besser435/Binary-NeoPixel-Clock/README.md

# Lightbeam S3
 
TODO:<br>
Take picutres<br>
Make CP build and upload to CP website<br>
