besser435/Binary-NeoPixel-Clock/3d_models/print_files/Lightbeam S3 Body.3mf

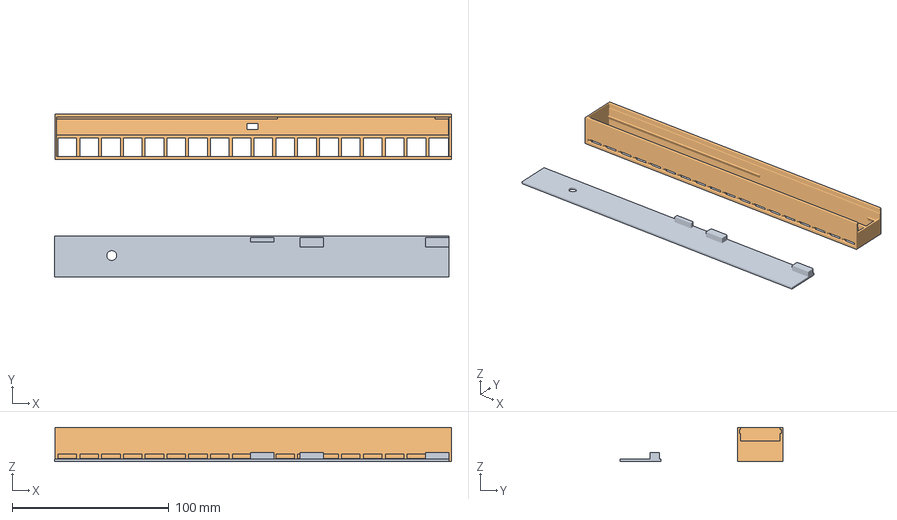
[picture p1: CAD file, 2024-04-17]
3d_models/print_files/Lightbeam S3 Body.3mf
253.3 x 104.3 x 22.0 mm
Lightbeam S3 (11).stl_1
Lightbeam S3 (11).stl_2
