besser435/Binary-NeoPixel-Clock/3d_models/print_files/Lightbeam S3 Diffuser.3mf

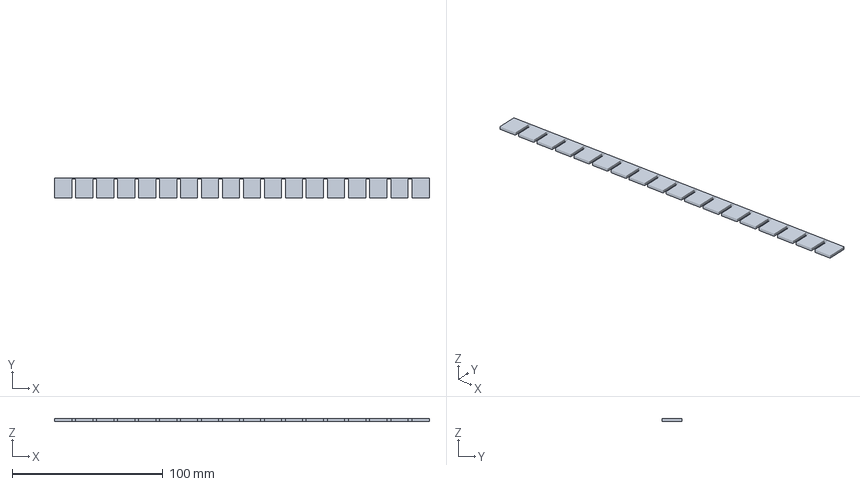
[picture p2: CAD file, 2024-04-17]
3d_models/print_files/Lightbeam S3 Diffuser.3mf
248.5 x 13.3 x 1.80 mm
