besser435/Binary-NeoPixel-Clock/lightbeam_s3_PCB/lightbeam_s3.kicad_pcb

## KiCad design lightbeam_s3_PCB/lightbeam_s3.kicad_pcb (2024-05-27)

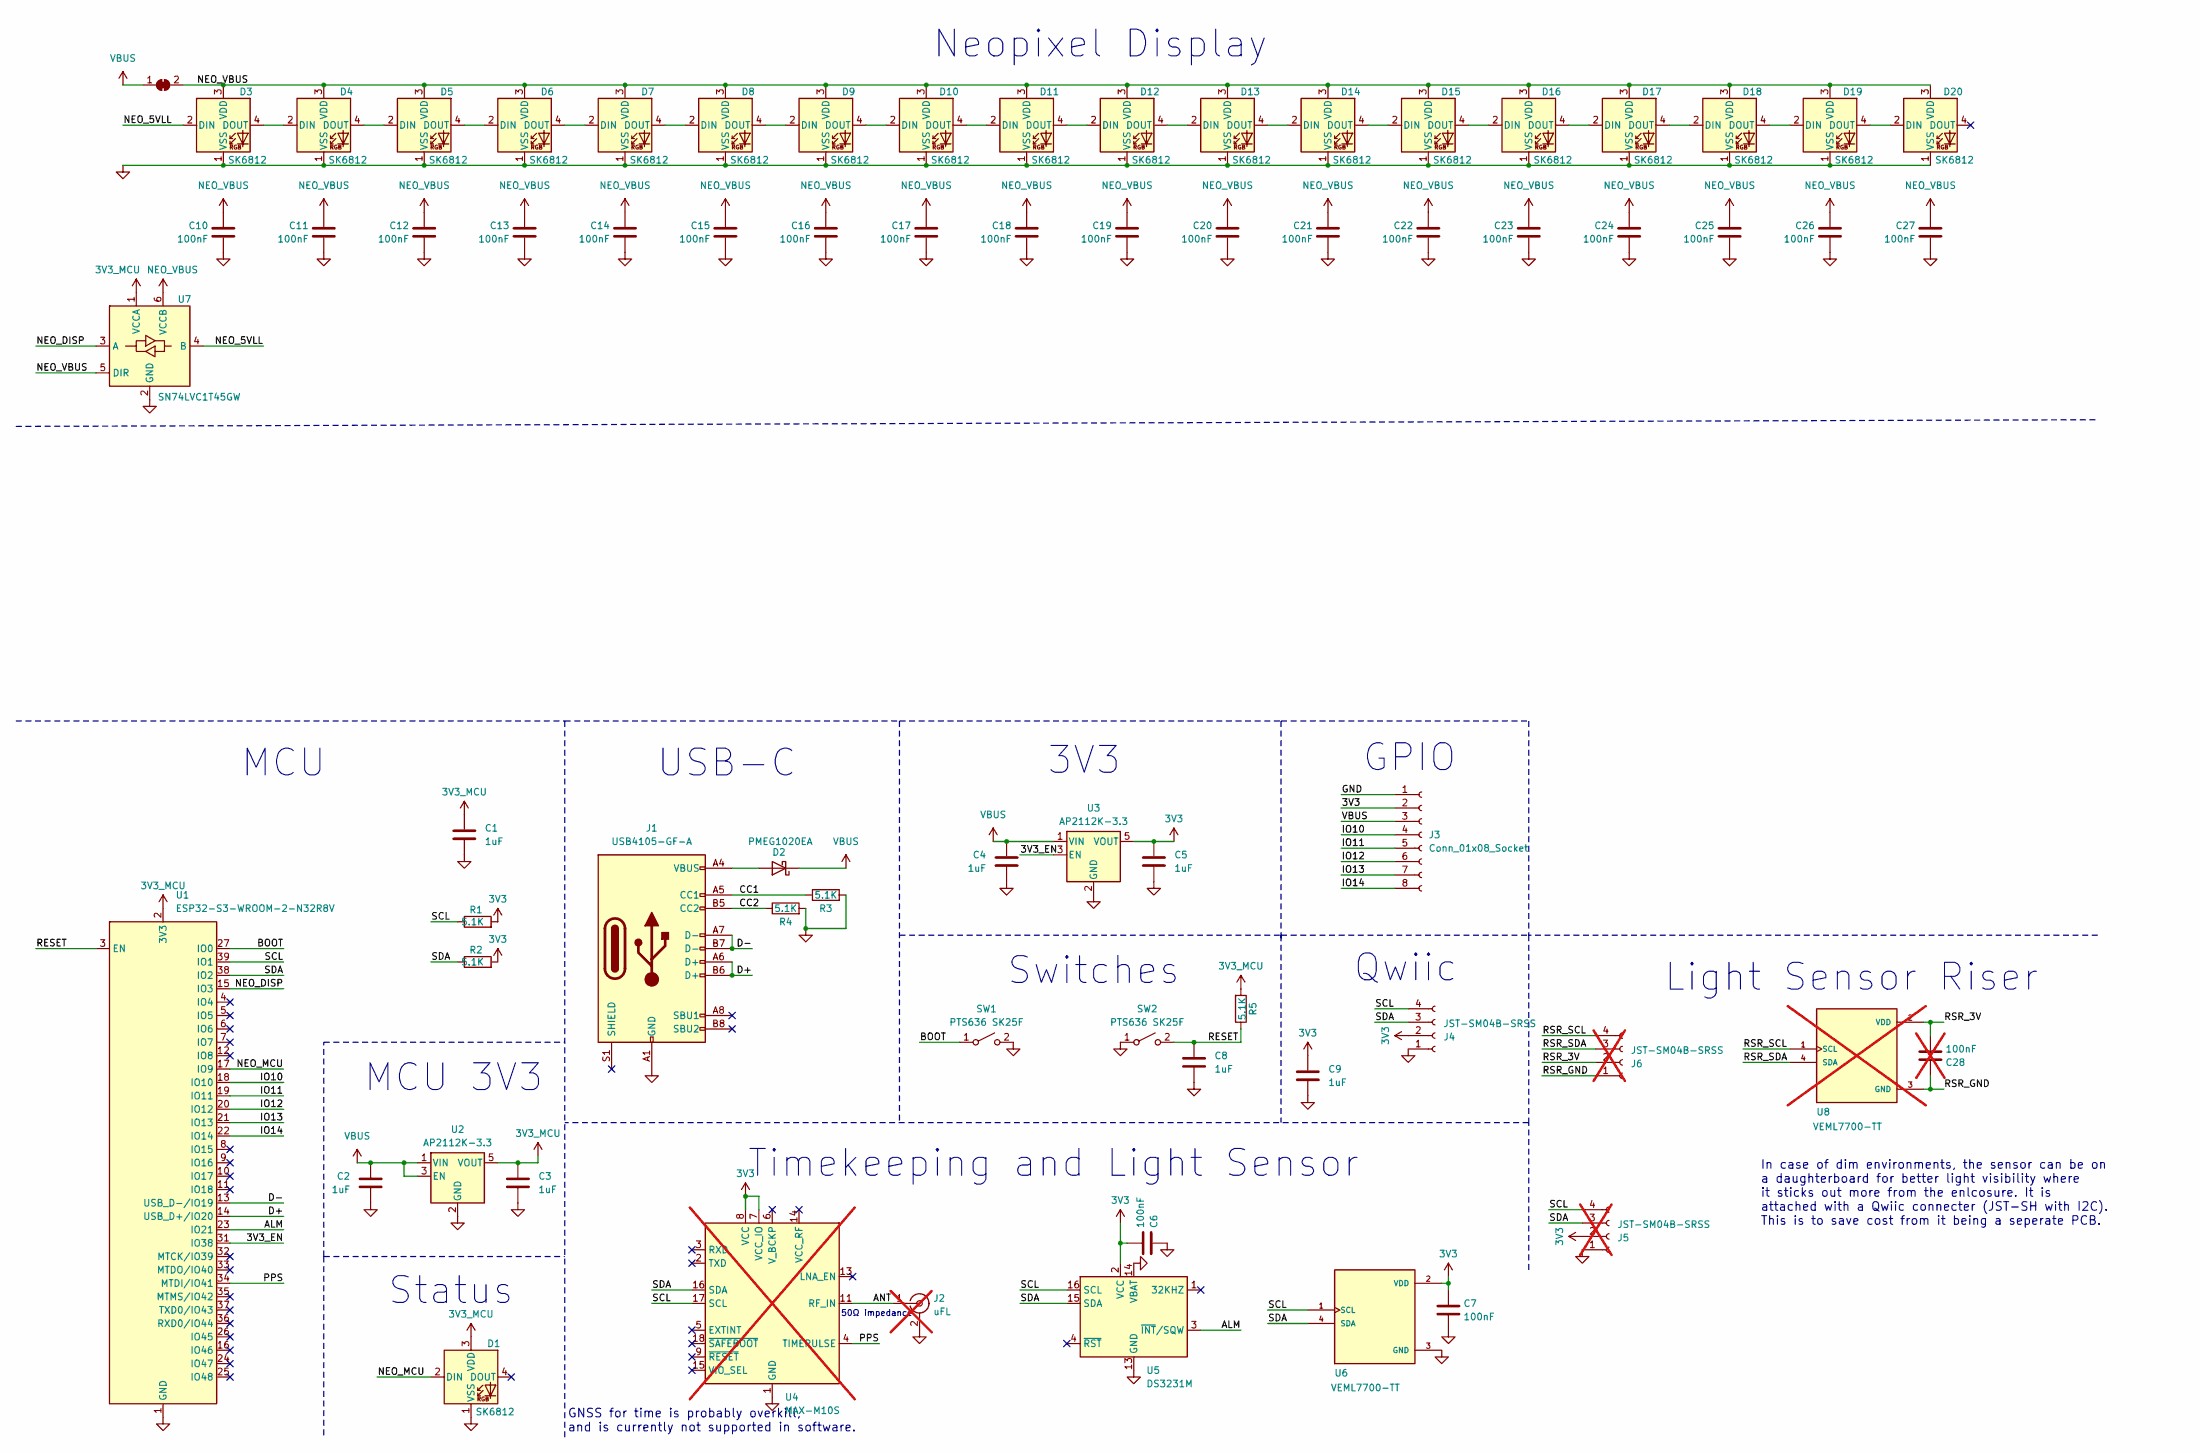
[picture p3: schematic lightbeam_s3.kicad_sch, Lightbeam S3]

Parts:
C1, C2, C3, C4, C5, C8, C9: 1uF; C_0603_1608Metric
C6, C7, C10, C11, C12, C13, C14, C15, C16, C17, C18, C19, C20, C21, C22, C23, C24, C25, C26, C27: 100nF; C_0603_1608Metric
C28: 100nF; C_0603_1608Metric; not fitted
D1, D3, D4, D5, D6, D7, D8, D9, D10, D11, D12, D13, D14, D15, D16, D17, D18, D19, D20: SK6812; LED_SK6812_PLCC4_5.0x5.0mm_P3.2mm
D2: PMEG1020EA; D_SOD-323
J1: USB4105-GF-A; USB_C_Receptacle_GCT_USB4105-xx-A_16P_TopMnt_Horizontal
J2: uFL; U.FL_Hirose_U.FL-R-SMT-1_Vertical; not fitted
J3: Conn_01x08_Socket; PinHeader_1x08_P2.54mm_Vertical
J4: JST-SM04B-SRSS; JST_SH_SM04B-SRSS-TB_1x04-1MP_P1.00mm_Horizontal
J5, J6: JST-SM04B-SRSS; JST_SH_SM04B-SRSS-TB_1x04-1MP_P1.00mm_Horizontal; not fitted
JP3: SolderJumper_2_Bridged; solder_jumper_bridged
R1, R2, R3, R4, R5: 5.1K; C_0603_1608Metric
SW1, SW2: PTS636 SK25F; SW_Tactile_SPST_NO_Straight_CK_PTS636Sx25SMTRLFS
U1: ESP32-S3-WROOM-2-N32R8V; ESP32-S3-WROOM-2
U2, U3: AP2112K-3.3; SOT-23-5
U4: MAX-M10S; ublox_MAX; not fitted
U5: DS3231M; SOIC-16W_7.5x10.3mm_P1.27mm
U6: VEML7700-TT; VEML7700; PARTREV 1.6
U7: SN74LVC1T45GW; SOT-363_SC-70-6
U8: VEML7700-TT; VEML7700; PARTREV 1.6; not fitted

Connections:
3V3: C5.1, C6.1, C7.2, C9.1, J3.2, J4.2, J5.2, R1.2, R2.2, U3.5 (VOUT), U4.7 (VCC_IO), U4.8 (VCC), U5.2 (VCC), U6.2 (VDD)
3V3_MCU: C1.1, C3.1, D1.3 (VDD), R5.2, U1.2 (3V3), U2.5 (VOUT), U7.1 (VCCA)
/3V3_EN: U1.31 (IO38), U3.3 (EN)
/ALM: U1.23 (IO21), U5.3 (~INT/SQW)
/ANT: J2.1 (In), U4.11 (RF_IN)
/BOOT: SW1.1 (A), U1.27 (IO0)
/CC1: J1.A5 (CC1), R3.1
/CC2: J1.B5 (CC2), R4.1
/D+: J1.A6 (D+), J1.B6 (D+), U1.14 (USB_D+/IO20)
/D-: J1.A7 (D-), J1.B7 (D-), U1.13 (USB_D-/IO19)
/IO10: J3.4, U1.18 (IO10)
/IO11: J3.5, U1.19 (IO11)
/IO12: J3.6, U1.20 (IO12)
/IO13: J3.7, U1.21 (IO13)
/IO14: J3.8, U1.22 (IO14)
/NEO_5VLL: D3.2 (DIN), U7.4 (B)
/NEO_DISP: U1.15 (IO3), U7.3 (A)
/NEO_MCU: D1.2 (DIN), U1.17 (IO9)
/PPS: U1.34 (MTDI/IO41), U4.4 (TIMEPULSE)
/RESET: C8.1, R5.1, SW2.2 (B), U1.3 (EN)
/RSR_3V: C28.1, J6.2, U8.2 (VDD)
/RSR_GND: C28.2, J6.1, U8.3 (GND)
/RSR_SCL: J6.4, U8.1 (SCL)
/RSR_SDA: J6.3, U8.4 (SDA)
/SCL: J4.4, J5.4, R1.1, U1.39 (IO1), U4.17 (SCL), U5.16 (SCL), U6.1 (SCL)
/SDA: J4.3, J5.3, R2.1, U1.38 (IO2), U4.16 (SDA), U5.15 (SDA), U6.4 (SDA)
GND: C1.2, C2.1, C3.2, C4.1, C5.2, C6.2, C7.1, C8.2, C9.2, C10.1, C11.1, C12.1, C13.1, C14.1, C15.1, C16.1, C17.1, C18.1, C19.1, C20.1, C21.1, C22.1, C23.1, C24.1, C25.1, C26.1, C27.1, D1.1 (VSS), D3.1 (VSS), D4.1 (VSS), D5.1 (VSS), D6.1 (VSS), D7.1 (VSS), D8.1 (VSS), D9.1 (VSS), D10.1 (VSS), D11.1 (VSS), D12.1 (VSS), D13.1 (VSS), D14.1 (VSS), D15.1 (VSS), D16.1 (VSS), D17.1 (VSS), D18.1 (VSS), D19.1 (VSS), D20.1 (VSS), J1.A1 (GND), J1.A12 (GND), J1.B1 (GND), J1.B12 (GND), J2.2 (Ext), J3.1, J4.1, J5.1, R3.2, R4.2, SW1.2 (B), SW2.1 (A), U1.1 (GND), U1.40 (GND), U1.41 (GND), U2.2 (GND), U3.2 (GND), U4.1 (GND), U4.10 (GND), U4.12 (GND), U5.5 (GND), U5.6 (GND), U5.7 (GND), U5.8 (GND), U5.9 (GND), U5.10 (GND), U5.11 (GND), U5.12 (GND), U5.13 (GND), U5.14 (VBAT), U6.3 (GND), U7.2 (GND)
NEO_VBUS: C10.2, C11.2, C12.2, C13.2, C14.2, C15.2, C16.2, C17.2, C18.2, C19.2, C20.2, C21.2, C22.2, C23.2, C24.2, C25.2, C26.2, C27.2, D3.3 (VDD), D4.3 (VDD), D5.3 (VDD), D6.3 (VDD), D7.3 (VDD), D8.3 (VDD), D9.3 (VDD), D10.3 (VDD), D11.3 (VDD), D12.3 (VDD), D13.3 (VDD), D14.3 (VDD), D15.3 (VDD), D16.3 (VDD), D17.3 (VDD), D18.3 (VDD), D19.3 (VDD), D20.3 (VDD), JP3.2 (B), U7.5 (DIR), U7.6 (VCCB)
unnamed: D2.2 (A), J1.A4 (VBUS), J1.A9 (VBUS), J1.B4 (VBUS), J1.B9 (VBUS)
unnamed: D3.4 (DOUT), D4.2 (DIN)
unnamed: D4.4 (DOUT), D5.2 (DIN)
unnamed: D5.4 (DOUT), D6.2 (DIN)
unnamed: D6.4 (DOUT), D7.2 (DIN)
unnamed: D7.4 (DOUT), D8.2 (DIN)
unnamed: D8.4 (DOUT), D9.2 (DIN)
unnamed: D9.4 (DOUT), D10.2 (DIN)
unnamed: D10.4 (DOUT), D11.2 (DIN)
unnamed: D11.4 (DOUT), D12.2 (DIN)
unnamed: D12.4 (DOUT), D13.2 (DIN)
unnamed: D13.4 (DOUT), D14.2 (DIN)
unnamed: D14.4 (DOUT), D15.2 (DIN)
unnamed: D15.4 (DOUT), D16.2 (DIN)
unnamed: D16.4 (DOUT), D17.2 (DIN)
unnamed: D17.4 (DOUT), D18.2 (DIN)
unnamed: D18.4 (DOUT), D19.2 (DIN)
unnamed: D19.4 (DOUT), D20.2 (DIN)
VBUS: C2.2, C4.2, D2.1 (K), J3.3, JP3.1 (A), U2.1 (VIN), U2.3 (EN), U3.1 (VIN)

Notes on the sheet:
Neopixel Display
MCU 3V3
50Ω impedance
In case of dim environments, the sensor can be on a daughterboard for better light visibility where it sticks out more from the enlcosure. It is attached with a Qwiic connecter (JST-SH with I2C). This is to save cost from it being a seperate PCB.
GPIO
USB-C
3V3
GNSS for time is probably overkill, and is currently not supported in software.
Timekeeping and Light Sensor
MCU
Status
Qwiic
Light Sensor Riser
Switches

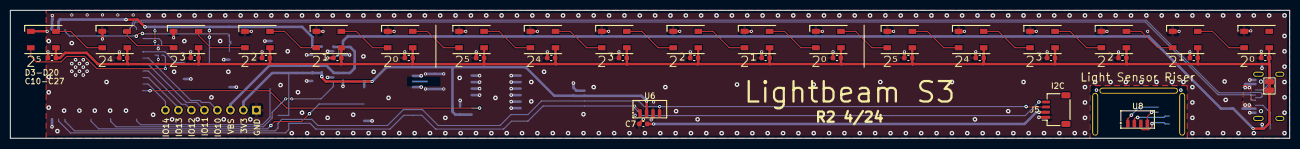
[picture p4: board lightbeam_s3.kicad_pcb from above]

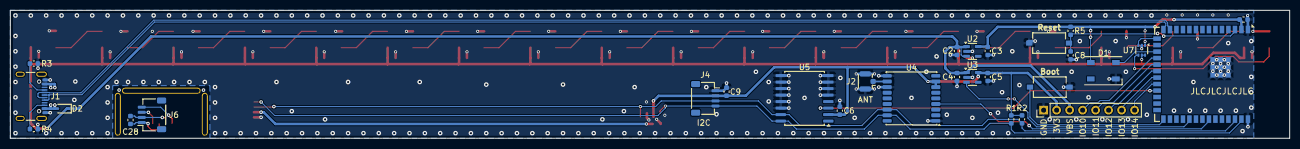
[picture p5: board lightbeam_s3.kicad_pcb from below]

Board: 4 copper layers, 250.0 x 25.0 mm, 70 parts (29 on the bottom side), 47 nets.
