besser435/Binary-NeoPixel-Clock/(commit log)

2024-03-14 Update stuff
    [binary_clock.kicad_pcb, binary_clock.kicad_sch]
2024-03-21 Update gitignore, PCB
    [binary_clock.kicad_pcb, binary_clock.kicad_sch]
2024-03-21 Update PCB
    [binary_clock.kicad_pcb, binary_clock.kicad_sch]
2024-03-21 Start on PCB
    [binary_clock.kicad_pcb, binary_clock.kicad_sch]
2024-03-26 Add final footprint positions
    [binary_clock.kicad_pcb, binary_clock.kicad_sch]
2024-03-26 Change schematic, start routing
    [binary_clock.kicad_pcb, binary_clock.kicad_sch]
2024-03-29 Almost finish placements
    [binary_clock.kicad_pcb, binary_clock.kicad_sch]
2024-03-29 fghxfhxcfhxfhgxfgh sxrfhxfr v
    [binary_clock.kicad_pcb]
2024-03-30 dead :pensive:
    [binary_clock.kicad_pcb, binary_clock.kicad_sch]
2024-03-31 Add gerber files
    [binary_clock.kicad_pcb, binary_clock.kicad_sch]
2024-03-31 Fix silkscreen part designators
    [binary_clock.kicad_pcb]
2024-04-10 Fix minor bugs, improve holes
    [binary_clock.kicad_pcb]
2024-04-10 Rename to "Lightbeam S3"
    [binary_clock.kicad_pcb, binary_clock.kicad_sch, lightbeam_s3.kicad_pcb, lightbeam_s3.kicad_sch]
2024-04-11 Increase diode to 2A
    [lightbeam_s3.kicad_pcb, lightbeam_s3.kicad_sch]
2024-04-12 Fix I2C lines, remove edge power line
    [lightbeam_s3.kicad_pcb, lightbeam_s3.kicad_sch]
2024-04-12 Improve grounding, move USB lines inward
    [lightbeam_s3.kicad_pcb]
2024-04-14 DNP GNSS module
    [lightbeam_s3.kicad_pcb, lightbeam_s3.kicad_sch]
2024-04-17 Add 3MF files for Bambu Lab P1S
    [Lightbeam S3 Body.3mf, Lightbeam S3 Diffuser.3mf]
2024-04-17 Improve PCB for the enclosure, clean traces, DNP GNSS
    [lightbeam_s3.kicad_pcb, lightbeam_s3.kicad_sch]
2024-05-27 Slight PCB changes
    [lightbeam_s3.kicad_pcb]
2024-06-21 Fix debug print times, remove old function, start with display off
    [lightbeam.py]
